ishtiakm/sign_language_interpreter/Report on sign language interpreter Device.pdf

Sign Language Interpreter Device

Introduction:

A lot of people among us do not have the ability to communicate with people by speaking. For these differently abled people there is a language called ASL (American Sign Language). But the problem is, even if some people know the signs, most of us do not know how to communicate to them with ASL. So, we proposed a design of a glove which can sense the Sign and interpret that in English, so that it becomes clear to people who do not understand sign language.

Instruments:

For detecting the motion of the wrist and fingers 6 flex sensors and 10 contact sensors are used. Flex sensors have a variable resistance which has a different value when it is bent compared to when it is straight. So it can be used to detect whether an individual finger is bent. Contact sensor senses whether different fingers touch each other. In understanding sign language it is vital to know which fingers are in contact. For that reason these many contact sensors are used to increase accuracy.

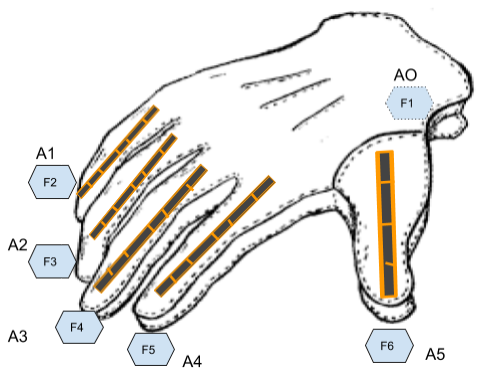
[picture p1: figure]

Figure: Back side of Glove with flex sensor and analog input notation

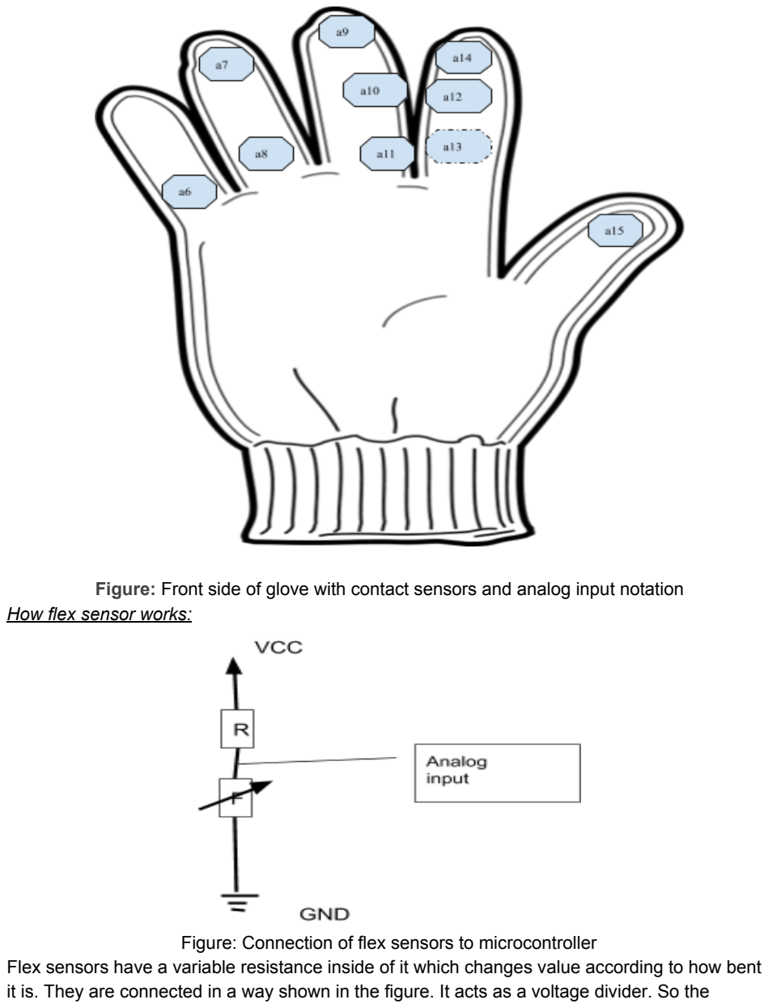
[picture p2: page 2]

Figure: Front side of glove with contact sensors and analog input notation How flex sensor works:

Figure: Connection of flex sensors to microcontroller Flex sensors have a variable resistance inside of it which changes value according to how bent it is. They are connected in a way shown in the figure. It acts as a voltage divider. So the change in resistance is picked up by a microcontroller as a voltage analog input and data are processed accordingly.

How contact sensors detects contact:

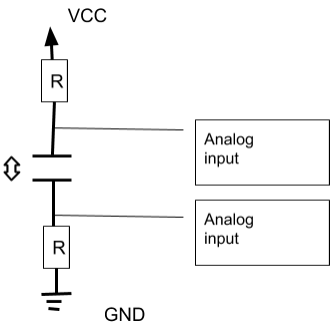
[picture p3: figure]

Figure: Connection of contact sensors to microcontroller Contact sensors used here are circular iron wire spirals.Some sensors are connected to VCC by a resistance and others are connected to GND by some resistance. When the contact sensors do not touch each other, the voltages picked up by microcontrollers are either VCC or 0. But, when the contact sensors are in contact, current flows from VCC to GND and voltage drop takes place at the voltage divider which is picked up by the microcontroller.

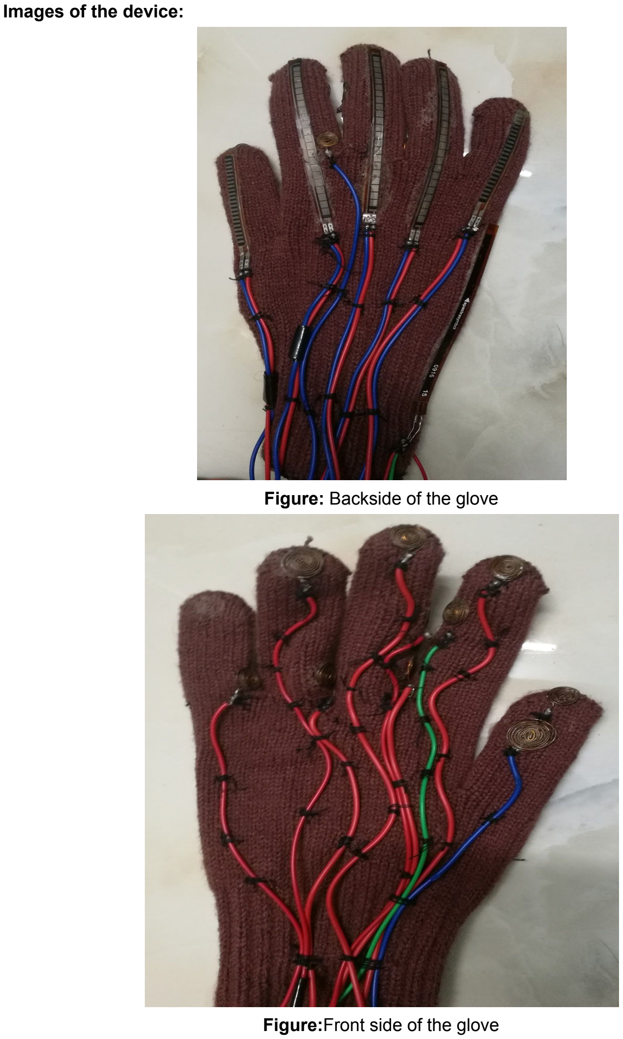
[picture p4: page 4]

Images of the device:

Figure: Backside of the glove

Figure:Front side of the glove

Description:
26 letters of english alphabet can be translated into sign language by the gestures of a single hand. These gestures required bending of different numbers of fingers and contact among them. With the 16 sensors installed on the glove, we can record the sensor values of the individual letters and try to learn the connection among the numbers.
A0 → Flex sensor in the wrist. Detects how much the wrist is bent
A1 → Flex sensor in the little finger. Detects how much it is bent.
A2 → Flex sensor in the ring finger. Detects how much it is bent. A3 → Flex sensor in the middle finger. Detects how much it is bent. A4 → Flex sensor in the index finger. Detects how much it is bent. A5 → Flex sensor in the thumb finger. Detects how much it is bent. A6 → Contact sensor in lower part of small finger. Connected to VCC. A7 → Contact sensor in upper part of ring finger. Connected to VCC.
A8 → Contact sensor in lower part of ring finger. Connected to VCC.
A9 → Contact sensor in upper part of middle finger. Connected to VCC. A10 → Contact sensor in middle part of middle finger. Connected to VCC. A11 → Contact sensor in lower part of middle finger. Connected to VCC. A12 → Contact sensor in middle part of index finger. Connected to GND. A13 → Contact sensor in back part of index finger. Connected to GND. A14 → Contact sensor in lower part of index finger. Connected to VCC. A15 → Contact sensor in upper part of thumb. Connected to GND.

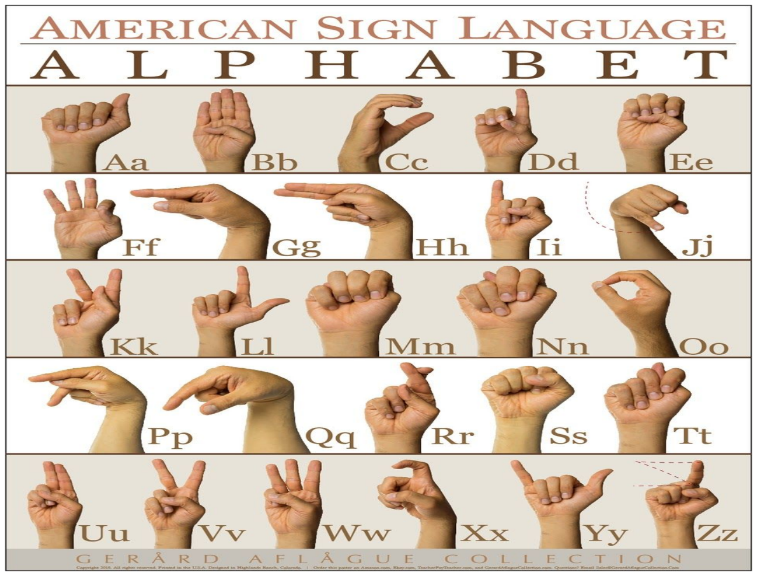
[picture p5: figure]

Figure: American Sign Language (ASL) Alphabet

Data collection:

For every letter nearly 50 samples are taken. These samples were cleaned up to remove any outliers. Mean value of every sensor of every letter is shown to understand the difference in between them.

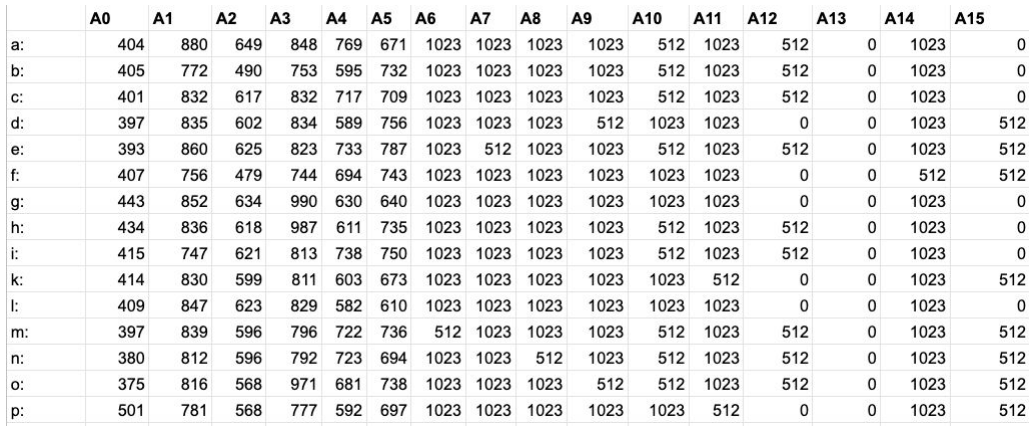
[picture p6: figure]
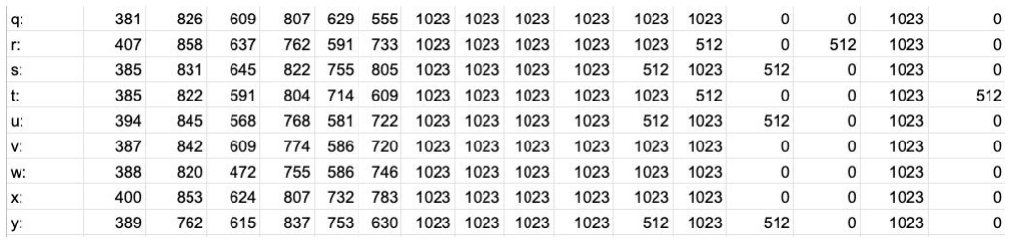
[picture p7: figure]

By looking at the data we can easily understand that the value of different sensors vary differently. The contact sensor has a range of 512 (from 0 to 512 or from 1023 to 512). On the other hand flex sensors have different ranges because of the nature of their internal resistor. Difference in letters like A and B can easily be understood by looking at the flex sensor inputs. But similar looking letters like U,V are tricky as the flex sensors show similar values. But the contact sensor differentiates them (A10,A12 shows that letter U requires contact of middle finger and index finger).

A lot of machine learning algorithms can be used to detect any new input by comparing that with a training set. But the nature of this project requires fast training and output. For that reason KNN ( K- nearest neighbourhood) algorithm is used to detect the result.

But there is a problem with using this data as a training set. As the contact sensors have higher ranges of values compared to flex sensors, during finding the right answers the input of contact sensors will dominate the result. If by any chance mistakenly any contact sensors are not in contact, that error will be weighted highly and it will ignore the similarity in flex sensor values and give us the wrong output

For that reason, the inputs should be normalized to have a mean of 0 and e standard deviation of 1. The values will be weighted equally and it will be more likely to find correct output ,even if there is a mistake in input.

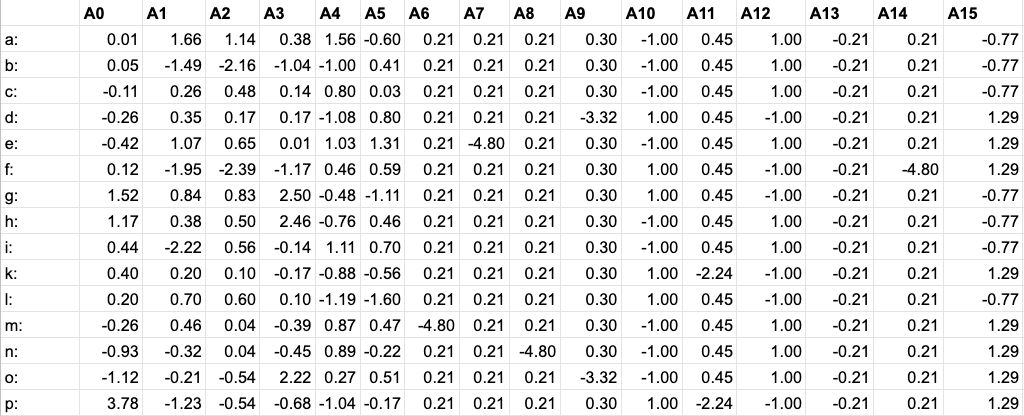
[picture p8: figure]
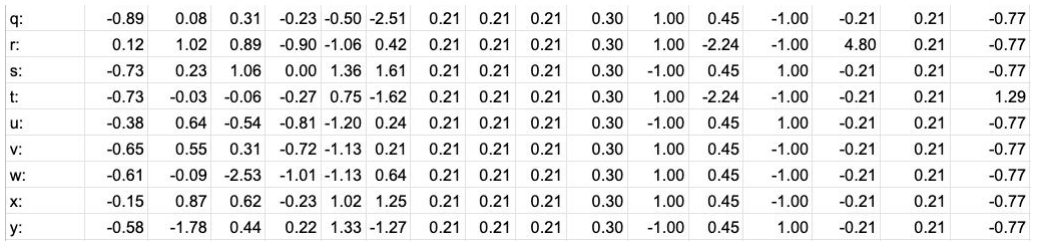
[picture p9: figure]

Figure: Normalized input data

Algorithm:

As a machine learning algorithm, KNN is chosen because of its relevance in this matter. In simple words, KNN plots the training data in a sample space having N(number of sensors) dimensions. When a new input is given, KNN plots that input in the sample space and finds its K nearest neighbours. Then it finds the neighbour who has the majority and accepts that as the answer. As the data shows variation between letters, this technique is meaningful and most intuitive and more likely to find the correct answer.

Result:
For evaluating the result, we took a testing dataset from the person who supplied the training data (as the gadget is most likely to be used by one person, so training data from that person matters the most). We also took some data from a different person to check the generality of the algorithm.
Letter | Accuracy(%)
A | 95
B | 92
C | 94
D | 97
E | 96
F | 94
G | 94
H | 95
I | 96
K | 96
L | 97
M | 92
N | 91
O | 94
P | 93
Q | 92
R | 96
S | 96
T | 92
U | 97
V | 93
W | 91
X | 95
Y | 96

The results show a high accuracy of more than 90%. Reason behind this high accuracy is the use of a large number of sensors and the use of machine learning. The slight amount of error is due to the fact that some test inputs were taken by different people wearing that glove. So the gestures varied as a different person gave the input. Moreover, some input was intentionally taken in a hurry which resulted in faulty contact sensor values. So accuracy can be increased further by taking the input more carefully.

Link of data and codes:

https://github.com/ishtiakm/sign_language_interpreter

Conclusion:

By using this gadget, a person can easily communicate with another person. More improvement can be done by training the glove to recognize words as well. The output can also be converted into audio. So, it will help a person to carry on a conversion in a much easier way.
