ishtiakm/sign_language_interpreter/database1test.csv

405 | 773 | 490 | 754 | 600 | 730 | 1023 | 1023 | 1023 | 1023 | 512 | 1023 | 512 | 0 | 1023 | 0 | B
404 | 880 | 649 | 848 | 769 | 671 | 1023 | 1023 | 1023 | 1023 | 512 | 1023 | 512 | 0 | 1023 | 0 | A
387 | 823 | 476 | 756 | 585 | 735 | 1023 | 1023 | 1023 | 1023 | 1023 | 1023 | 0 | 0 | 1023 | 0 | W
413 | 758 | 619 | 811 | 736 | 747 | 1023 | 1023 | 1023 | 1023 | 512 | 1023 | 512 | 0 | 1023 | 0 | I
387 | 818 | 473 | 756 | 588 | 743 | 1023 | 1023 | 1023 | 1023 | 1023 | 1023 | 0 | 0 | 1023 | 0 | W
405 | 760 | 481 | 752 | 695 | 744 | 1023 | 1023 | 1023 | 1023 | 1023 | 1023 | 0 | 0 | 512 | 512 | F
414 | 754 | 620 | 811 | 737 | 749 | 1023 | 1023 | 1023 | 1023 | 512 | 1023 | 512 | 0 | 1023 | 0 | I
389 | 777 | 613 | 848 | 753 | 631 | 1023 | 1023 | 1023 | 1023 | 512 | 1023 | 512 | 0 | 1023 | 0 | Y
391 | 832 | 606 | 774 | 585 | 714 | 1023 | 1023 | 1023 | 1023 | 1023 | 1023 | 0 | 0 | 1023 | 0 | V
451 | 855 | 635 | 991 | 629 | 642 | 1023 | 1023 | 1023 | 1023 | 1023 | 1023 | 0 | 0 | 1023 | 0 | G
395 | 842 | 606 | 777 | 586 | 718 | 1023 | 1023 | 1023 | 1023 | 1023 | 1023 | 0 | 0 | 1023 | 0 | V
404 | 848 | 621 | 827 | 581 | 610 | 1023 | 1023 | 1023 | 1023 | 1023 | 1023 | 0 | 0 | 1023 | 0 | L
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
